MikkoKivekas/PAC-SLI/CAD/README

CAD files of 3D-printed electronics boxes.
CADs made with Autedosk Inventor and there is some print ready STL-files.
