MikkoKivekas/PAC-SLI/CAD/PAC-SLI furnace Rv6 base.igs

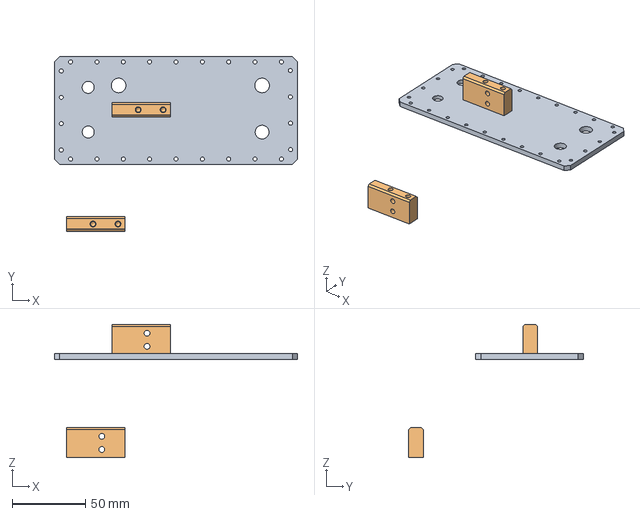
[picture p2: CAD file, 2019-07-17]
CAD/PAC-SLI furnace Rv6 base.igs
166.0 x 119.3 x 91.0 mm
