MikkoKivekas/PAC-SLI/CAD/QSH4218-35.stp

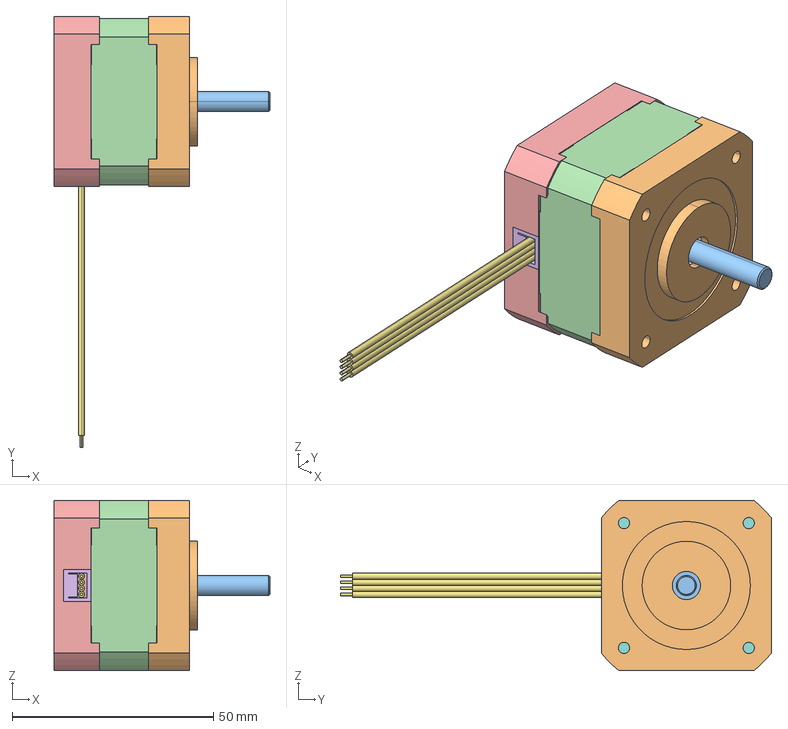
[picture p3: CAD file, 2019-07-17]
CAD/QSH4218-35.stp
53.6 x 107.1 x 42.3 mm
1_1_02_EB421-003
ZHUANZI
TIEXIN
1_1_04_EB422-004
HUXIANTAO
YINCHUXIANHEI
YINCHUXIANLV
YINCHUXIANHONG
YINLCHUXIANLAN
LUODING x 4
