MikkoKivekas/PAC-SLI/CAD/TCbox.stl

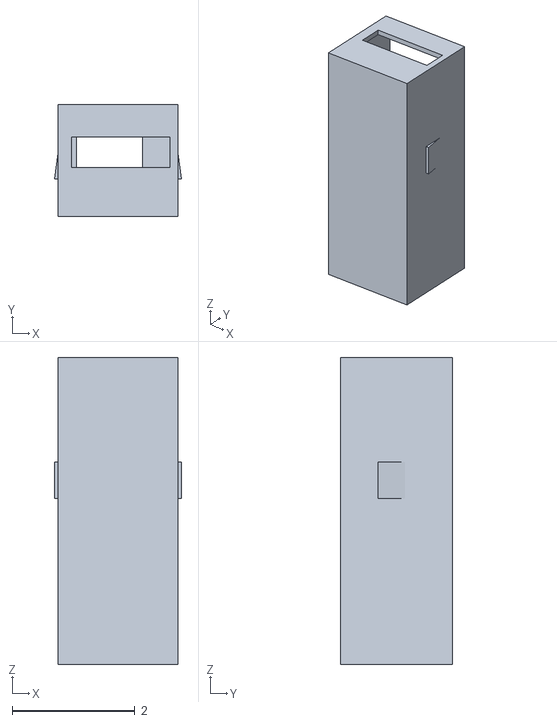
[picture p4: CAD file, 2019-07-10]
CAD/TCbox.stl
2.07 x 1.83 x 5.00
