MikkoKivekas/PAC-SLI/CAD/TCLid.stl

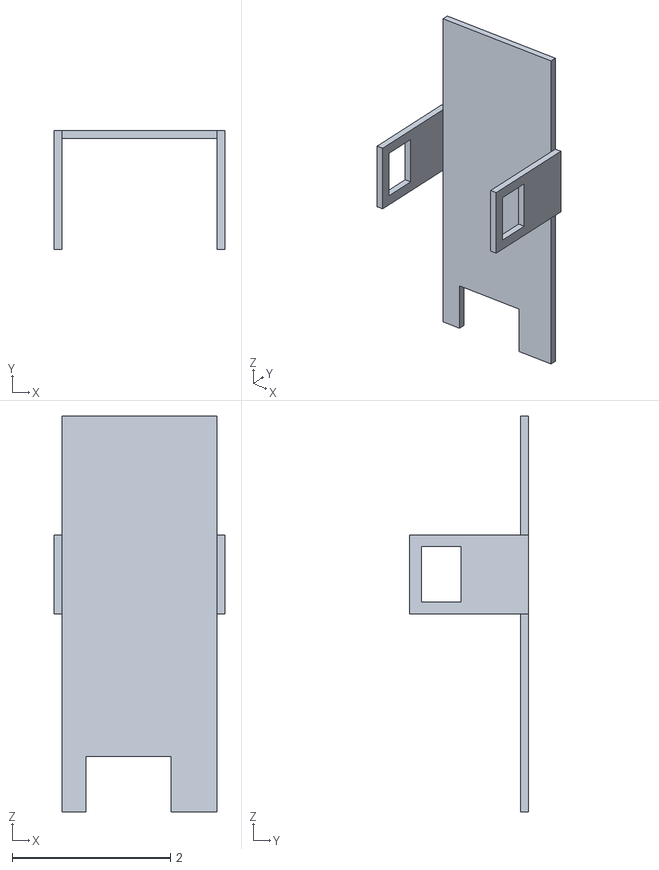
[picture p5: CAD file, 2019-07-10]
CAD/TCLid.stl
2.16 x 1.50 x 5.00
