MikkoKivekas/PAC-SLI/(list of files, cad)

Other CAD files:
CAD/Enclosure.dwg
CAD/MotorSupport2.dwg
CAD/EncoderDisk.dwg
CAD/133601.ipt
CAD/725.16.ipt
CAD/Enclosure.ipt
CAD/EncoderDisk.ipt
CAD/MotorSupport2.ipt
CAD/PACSLI_motor_assembly.iam
CAD/PhotogateCover.ipt
CAD/PhotogateCoverBox.ipt
CAD/PhotogateCoverLid.ipt
CAD/QSH4218-35.ipt
CAD/QSH4218-35rev2.ipt
CAD/TCLid.ipt
CAD/TCampBox.ipt
CAD/TCbox.ipt
CAD/TTL-RS232transreceiverCover.ipt
CAD/TTL-RS232transreceiverCoverBox.ipt
CAD/TTL-RS232transreceiverCoverLid.ipt
