MikkoKivekas/PAC-SLI/CAD/Enclosure.pdf

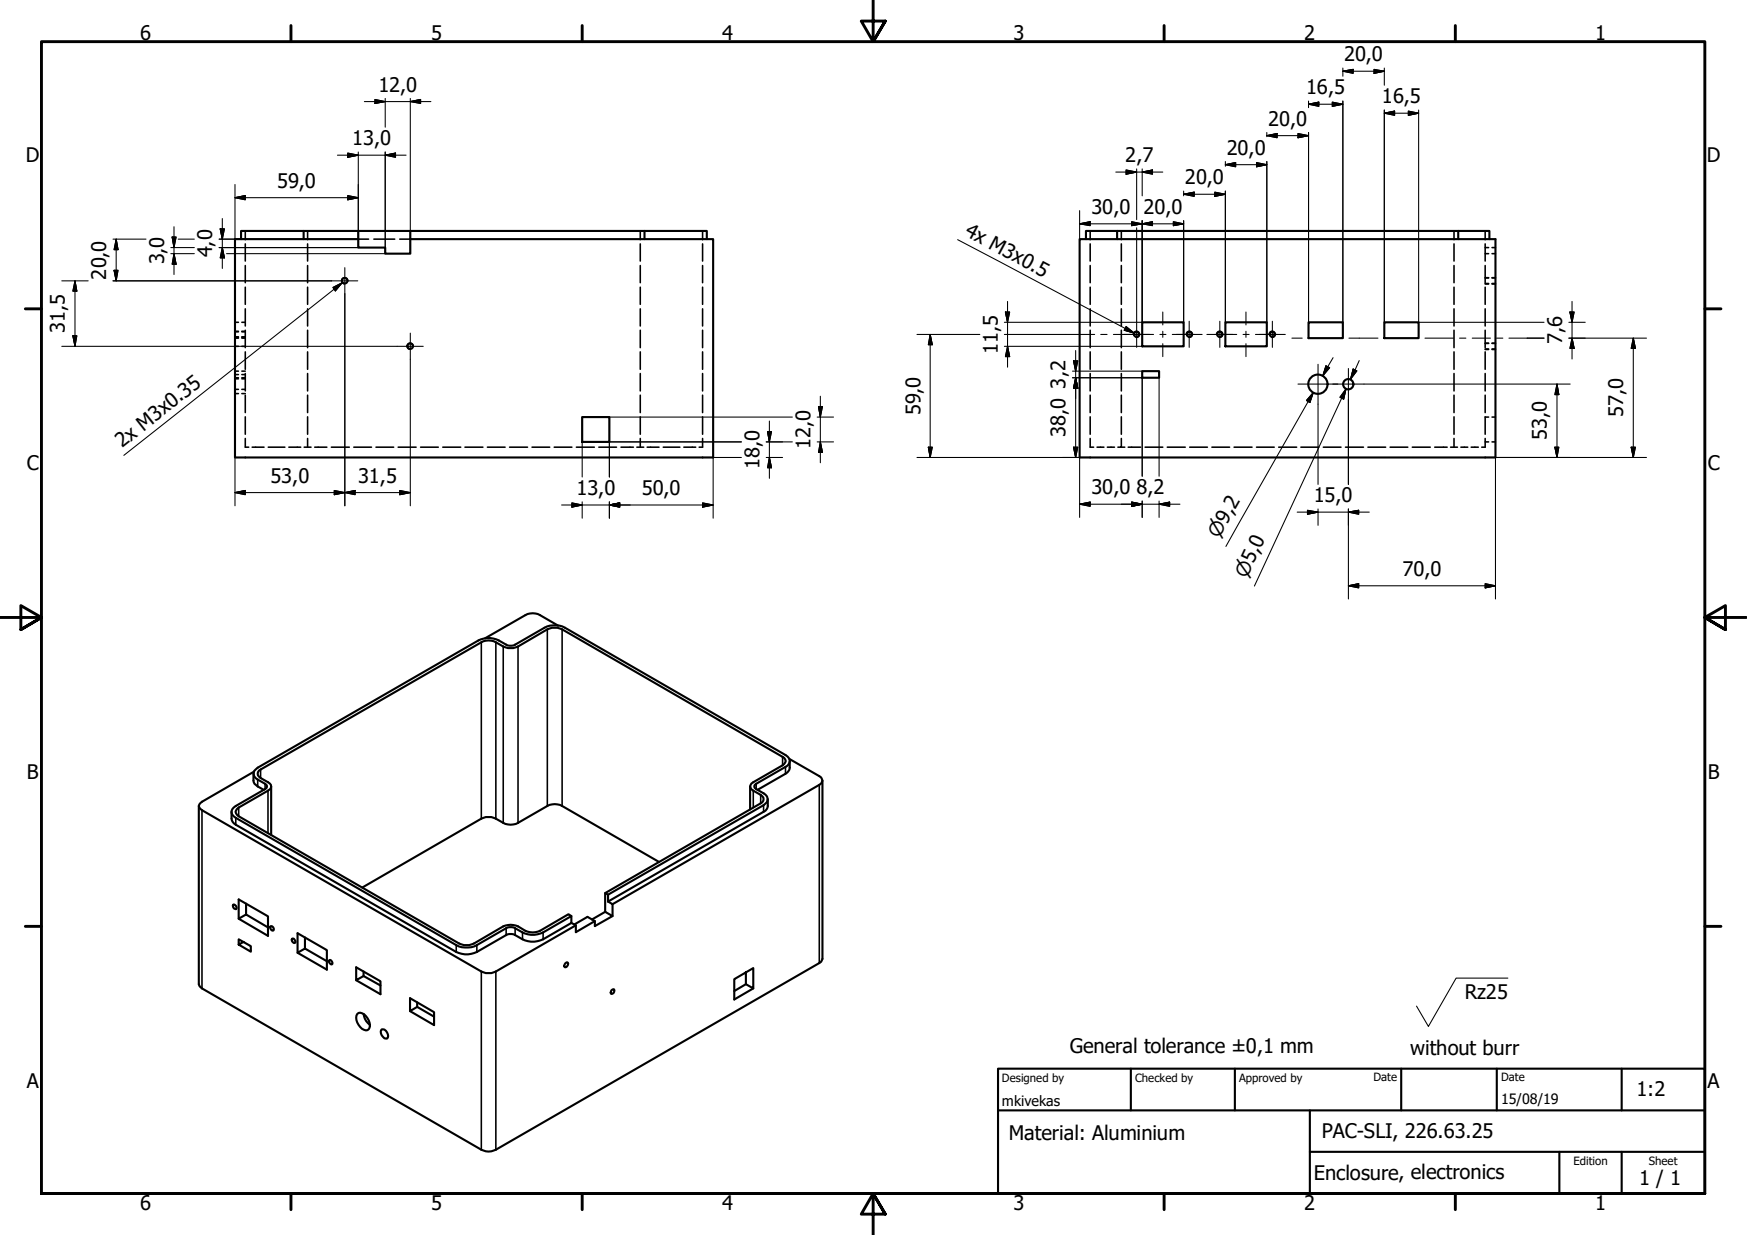
[picture p6: page 1]
General tolerance ±0,1 mm; without burr

Designed by mkivekas | Checked by | Approved by Date | Date 15/08/19 | 1:2

Material: Aluminium | PAC-SLI, 226.63.25

Enclosure , electronics | Edition | Sheet 1 / 1
