MikkoKivekas/PAC-SLI/CAD/EncoderDisk.pdf

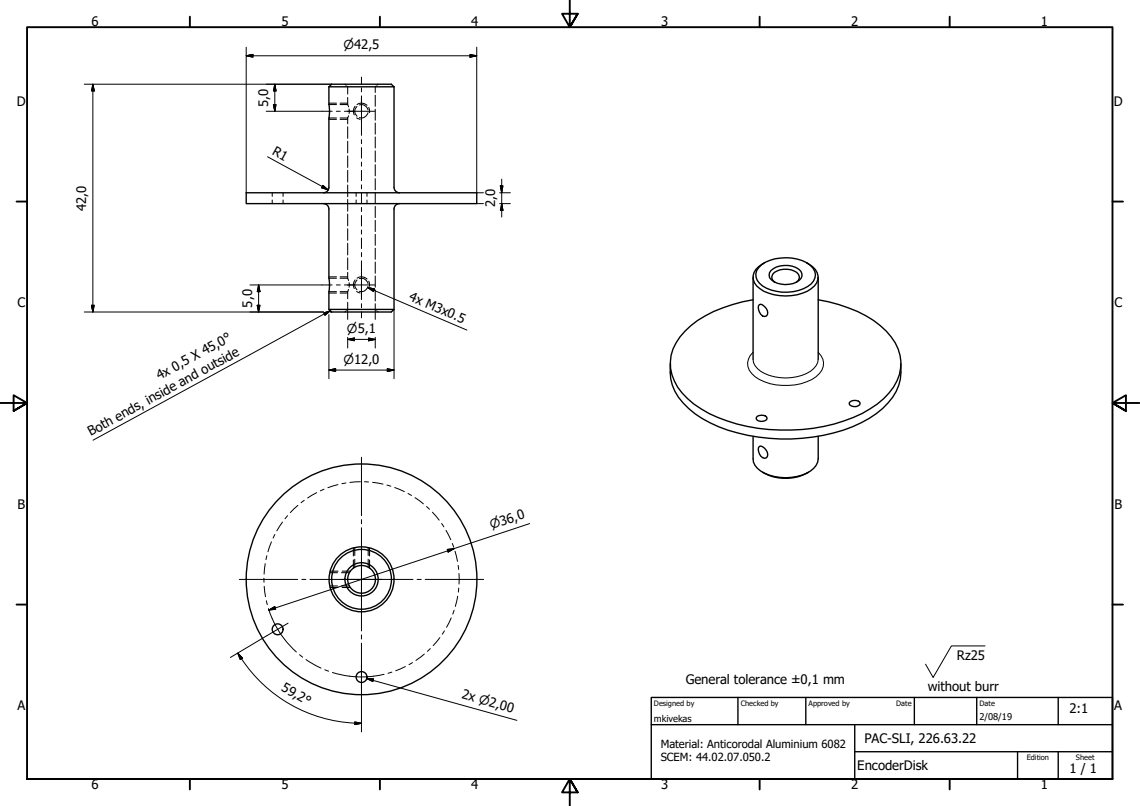
[picture p7: page 1]
Both ends,; without burr

inside and outside

General tolerance ±0,1 mm

Designed by mkivekas | Checked by | Approved by Date | Date 2/08/19 | 2:1

Material: Anticorodal Aluminium 6082 SCEM: 44.02.07.050.2 | PAC-SLI, 226.63.22

EncoderDisk | Edition | Sheet 1 / 1
