MikkoKivekas/PAC-SLI/CAD/PhotogateSupport.pdf

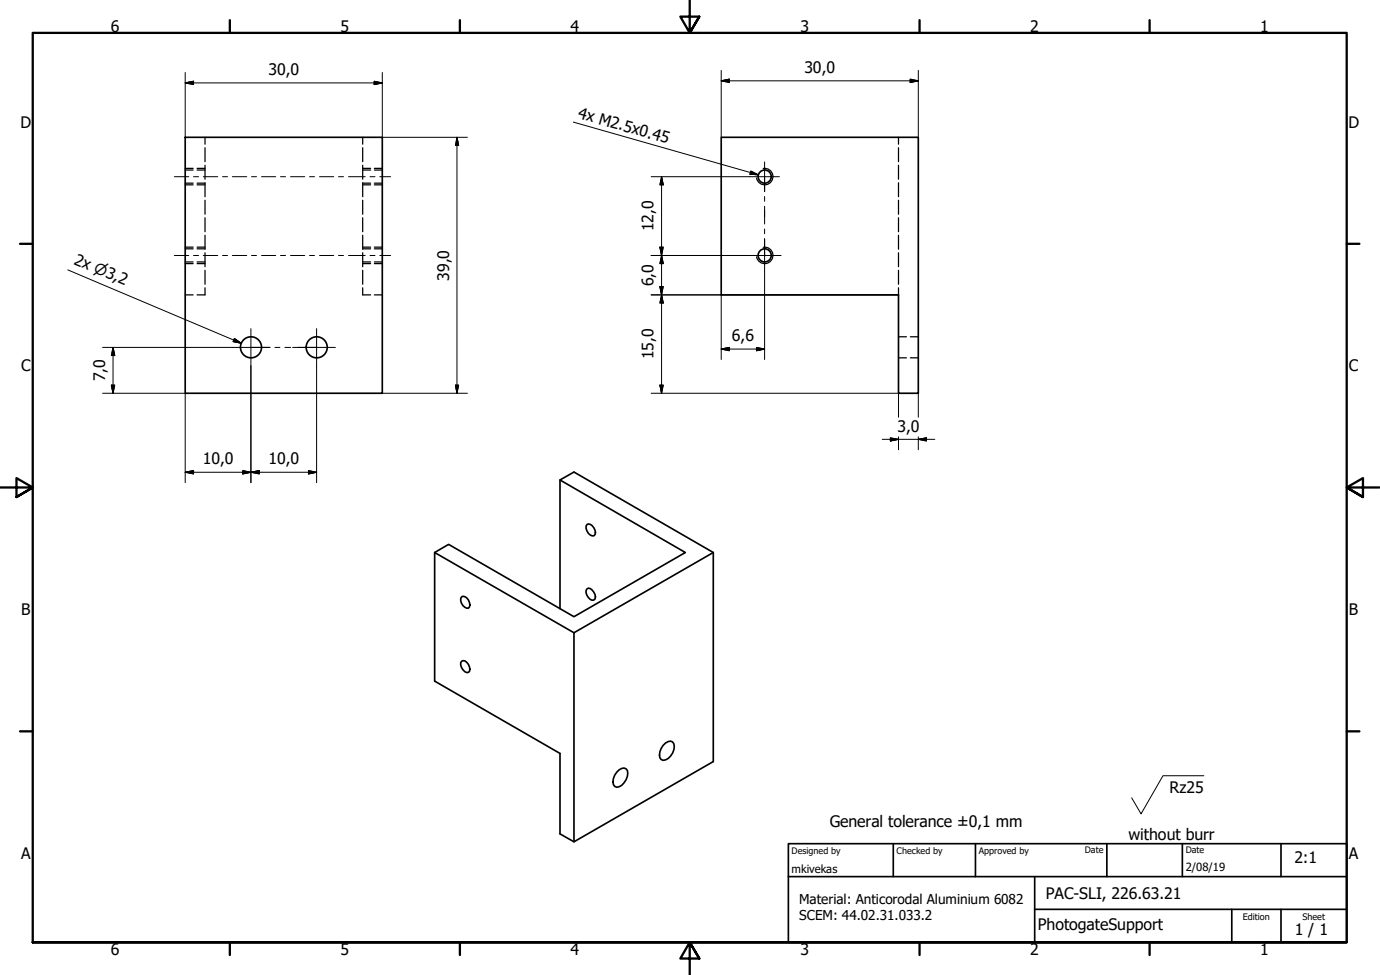
[picture p9: page 1]
without burr

General tolerance ±0,1 mm

Designed by mkivekas | Checked by | Approved by Date | Date 2/08/19 | 2:1

Material: Anticorodal Aluminium 6082 SCEM: 44.02.31.033.2 | PAC-SLI, 226.63.21

PhotogateSupport | Edition | Sheet 1 / 1
