MikkoKivekas/PAC-SLI/(notices)

Notices in the files:
CAD/PAC-SLI furnace Rv6 base.igs:
Data from Parasolid IGES Translator 19.0.9, Copyright(c) 2006 Siemens PLS 1
M Software. All Rights Reserved. S 2
